NorthCoastModularCollective/BridgeSystemOnRampPrototype/README.md

# BridgeSystemOnRampPrototype
a pure data prototype for the bridge system on ramp
