NorthCoastModularCollective/BridgeSystemOnRampPrototype/hardware/README.MD

This folder contains the designs for PCBs, panels, and other hardware items for the Bridge System Onramp.

Pinout map for v1 hardware
|Pin| MIDI CC | Component|
|----|---|---|
|0| N/A | Decay Input Jack |
|1| N/A | MISO (LCD Screen)|
|2| 17 | Trigger Button|
|3| N/A| SRR (shaper) Input Jack |
|4| N/A | Filter Cutoff Input Jack |
|5| N/A | Envelope Attack Input Jack |
|6| N/A| Waveform Selector Input Jack |
|7| N/A | DIN (SGTL5000 Audio Chip)|
|8| N/A | DOUT (SGTL5000 Audio Chip)|
|9| N/A | Clock Output Jack|
|10| N/A | Trigger Output Jack|
|11| N/A | MOSI (LCD Screen)|
|12| N/A | Sequencer Output Jack|
|13| N/A | Sequencer 4th LED|
|14| 30 | LFO Wave Knob |
|15| 28 | Envelope Attack Input Jack |
|16| 26| SRR (shaper) Input Jack |
|17| 27 | Filter Cutoff Knob |
|18| N/A |SDA (SGTL5000 Audio Chip)|
|19| N/A |SCL (SGTL5000 Audio Chip)|
|20| N/A |LRCLCK (SGTL5000 Audio Chip)|
|21| N/A |BLCK (SGTL5000 Audio Chip)|
|22| 31| LFO Rate Knob |
|23| 32 | LFO Amount Knob |
|24| 44 | Sequencer Fader 1|
|25| 45| Sequencer Fader 2|
|26| 46 | Sequencer Fader 3|
|27| 47 | Sequencer Fader 4|
|28| N/A | LFO Output Jack|
|29| N/A |Sequencer 1st LED|
|30| N/A |Sequencer 2nd LED|
|31| N/A |Sequencer 3rd LED|
|32| N/A | Reset (LCD Screen)|
|33| N/A | MCLK (SGTL5000 Audio Chip)|
|34| 17 | Clock Start/stop Button|
|35| N/A | Rotary Encoder A (clock speed)|
|36| N/A | RS (LCD Screen)|
|37| N/A | CS1 (LCD Screen)|
|38| N/A | Rotary Encoder B (clock speed)|
|39| N/A | Clock LED|
|40| 23 | Envelope Decay Knob|
|41| 25| Oscillator Waveform Knob |
