NorthCoastModularCollective/BridgeSystemOnRampPrototype/hardware/panel/Artboard 1.png

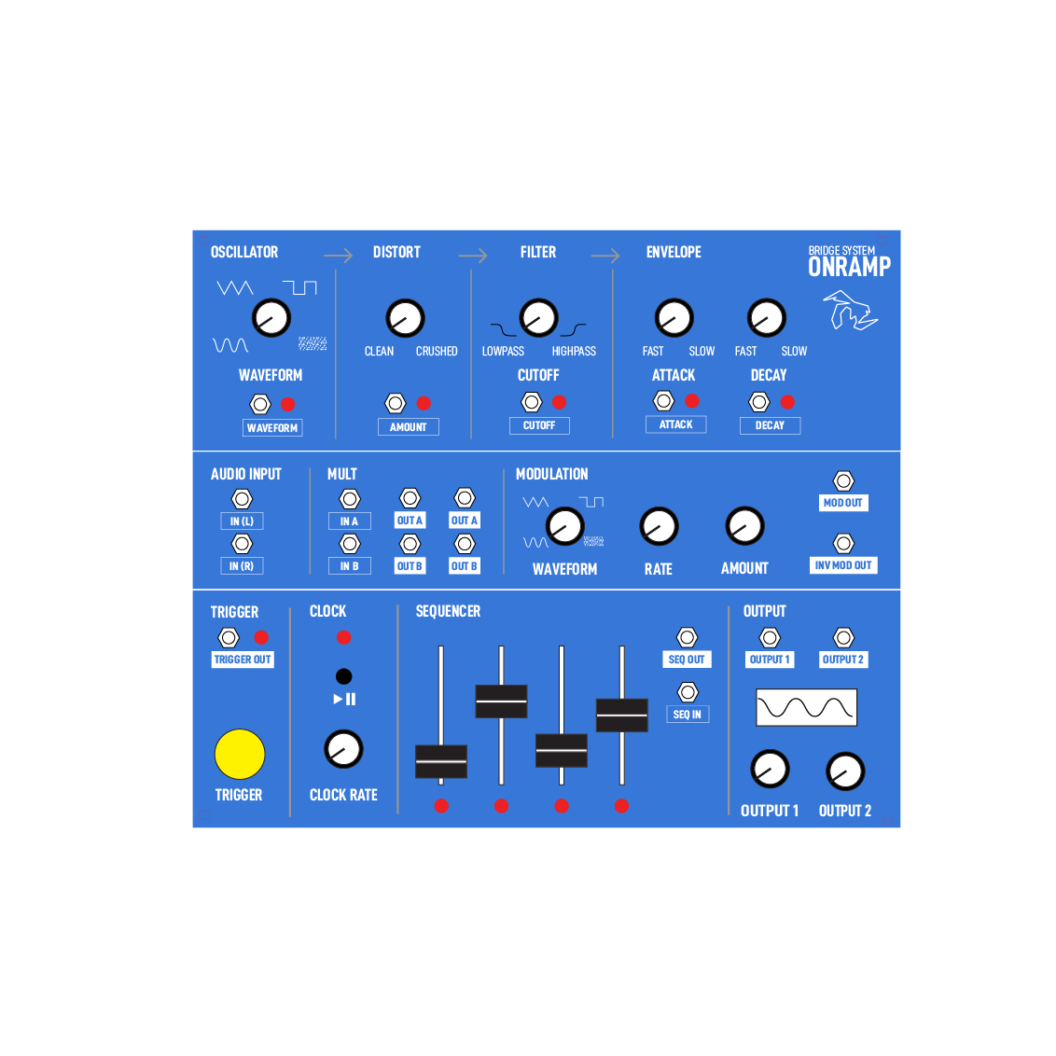
hardware/panel/Artboard 1.png
