NorthCoastModularCollective/BridgeSystemOnRampPrototype/(threads)

Thread 1 (2022-08-02):

TO DO - Onramp PD Prototyp

billvanloo, 2022-08-02:
These are the remaining "TO DO" items from the list @XiNNiW and I made as we were pairing on the PD prototype:

- [ ] Implement resonance control on the filter (PD doesn't give a way to do this for the lop~ or hip~ objects, and trying to implement this on the lpf~ object alone didn't seem quite right. If I remember correctly, David played a bit with using the biquad~ filter object to build our own filters from scratch, but I don't think it's all the way there.
- [ ] Add a layer of abstraction to the PD patch to hide the patch cords between sub-modules. This is a look-and-feel improvement to help the interface feel a little nicer.
- [ ] Add "fade-able" LEDs to reflect the knob or knob+modulation parameters. The idea here is that if a module's parameter can accept modulation, then the LED's brightness value should track the modulation and use PWM to fade the LED. In PD, this probably means building an abstraction to show how this would look.
- [ ] Refactor our patchbay into its own abstraction (@XiNNiW did we already do this?)
- [ ] Add the ability for the sequencer to run at LFO rate (I'm not sure what this note means exactly)
- [ ] Clean up each sub-module's GUI (line up elements, consistent font size & placement, etc)
- [ ] add an "envelope" to the modulation source's wave generation options
- [ ] Add "analog" outpuut from wave generator and two "analog" inputs to output module section (again, not sure what this means exactly)
- [ ] Further work needs to be done on the sequencer; will have to look further at this to give detailed description of what functionality is there and what still needs to be implemented.

Thread 2 (2023-05-27):

OLED schematic needs LED power

joebauer, 2023-05-27:
MH1 and MH2 are the power leads

joebauer, 2023-12-22:
This was added to the OLED breakout board. This board has been built but needs to be tested yet.

Thread 4 (2023-12-03):

Story: Display a line graphic on the LCD

billvanloo, 2023-12-03:
Story:
Display a line graphic on the LCD screen.

Details:
This will set the groundwork for our graphical display on the LCD screen. For now, just make a basic shape (ex: a square) be displayed on the screen.

billvanloo, 2023-12-03:
See also:
[](https://github.com/NorthCoastModularCollective/BridgeSystemOnRampPrototype/issues/3)

Thread 7 (2023-12-03):

Story: use onboard audio output

billvanloo, 2023-12-03:
Story:
Use onboard audio output

Details:
Use the new audio breakout board to get audio out of the prototype system instead of the USB audio output.

billvanloo, 2023-12-03:
Notes: @joebauer has the new audio breakout board hardware, and he will solder it up for testing. Once the hardware is complete, it should be possible to easily change the software/prototyping/audio-test code to use this instead of the USB output.

Thread 9 (2023-12-05):

Discussion: Filter Section

billvanloo, 2023-12-05:
During the last work session with @joebauer and @thynk we discussed a few possible changes to the filter section.

1. We discussed adding back the resonance control, since we're moving to the MUX board which gives us additional inputs.
2. We also discussed the possibility of adding a second filter section, so the instrument would have both lowpass and highpass filters as separate filters. These could be combined to create a bandpass effect. These would have separate cutoff controls, and could either share a common resonance control or have their own resonance controls.
3. We also discussed the possibility of moving from the DJ-style filter control (where it's a lowpass when turned to the left, or a highpass when turned to the right) to using a selector switch of some kind to switch between different filter types (lowpass, bandpass, highpass). In my head, I'm envisioning something like what the Jove filter uses:

https://dt7v1i9vyp3mf.cloudfront.net/styles/news_large/s3/imagelibrary/M/Modular_0917_02-lGJUXO5uQRmUUBVdWYKJVOYRkZ5P_l0y.jpg

billvanloo, 2023-12-05:
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

joebauer, 2023-12-22:
I think I might be leaning more to option #3, but perhaps with the selector being another knob (one I/O used vs. 4?)?
