NorthCoastModularCollective/BridgeSystemOnRampPrototype/hardware/Bridge System On Ramp Prototype001 Panel.pdf

# North Coast Modular Collective

# Attack IN1 TM⁵

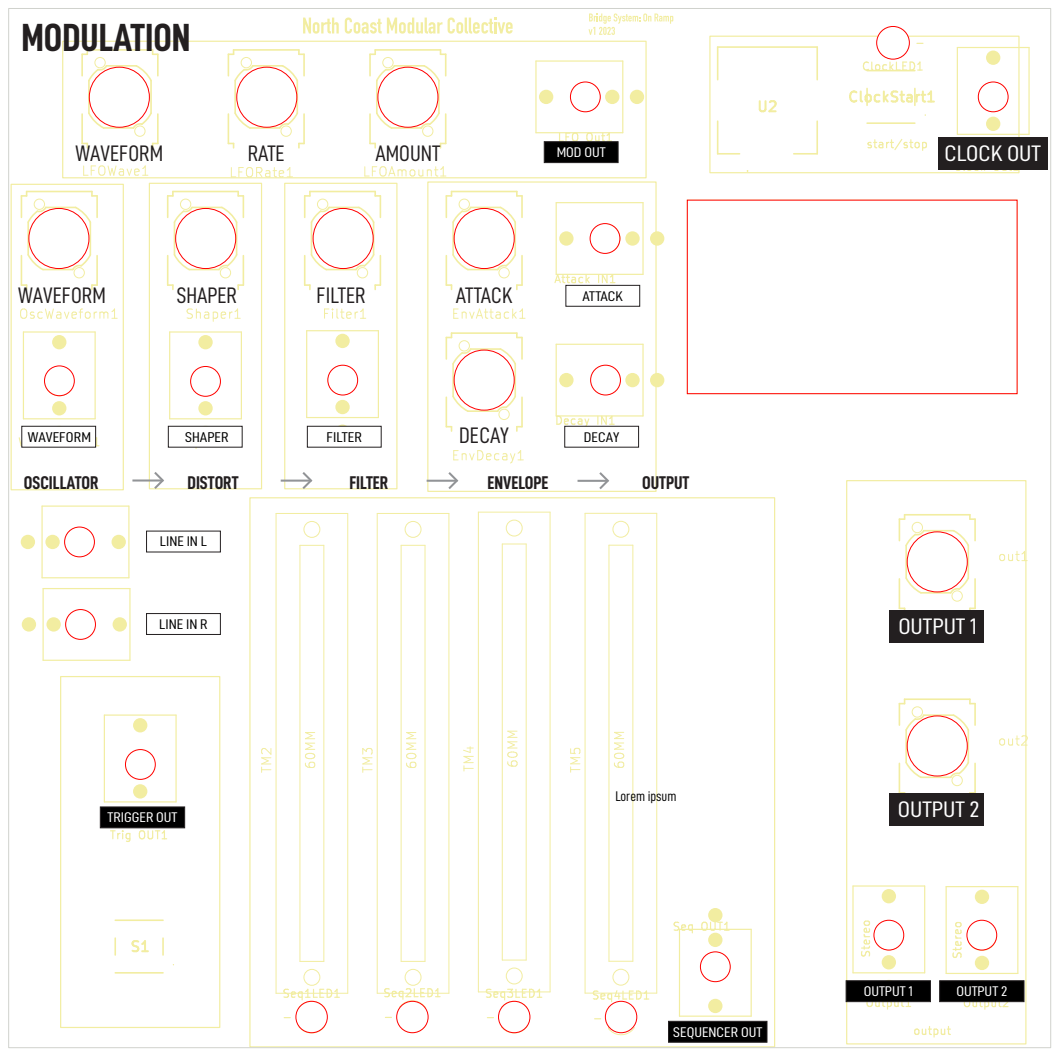
[picture p2: page 1]
Stereo; output; start/stop; LFOAmount1; Shaper1; Seq4LED1; Filter1; Seq2LED1; Output2; out1; Clock; Out1; LCDScreen1; LFO Out1; EnvDecay1; Seq1LED1; Output1 Seq3LED1; Trig OUT1; LineIn_L1; EnvAttack1; out2; LineIn_R1; OscWaveform1; Seq OUT1; Waveform; Shaper; 60MM Filter IN1; Decay IN1; ClockLED1; LFOWave1; ClockStart1; LFORate1; WAVEFORM; SHAPER; FILTER; ATTACK; DECAY; RATE; AMOUNT; MOD OUT; OUTPUT 1; OUTPUT 2; CLOCK OUT; LINE IN L; LINE IN R; TRIGGER OUT; SEQUENCER OUT; Lorem ipsum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

Bridge System: On Ramp
