NorthCoastModularCollective/BridgeSystemOnRampPrototype/hardware/panel/Bridge System Onramp interface ideas v6.pdf

## OSCILLATOR

DISTORT | FILTER | ENVELOPE

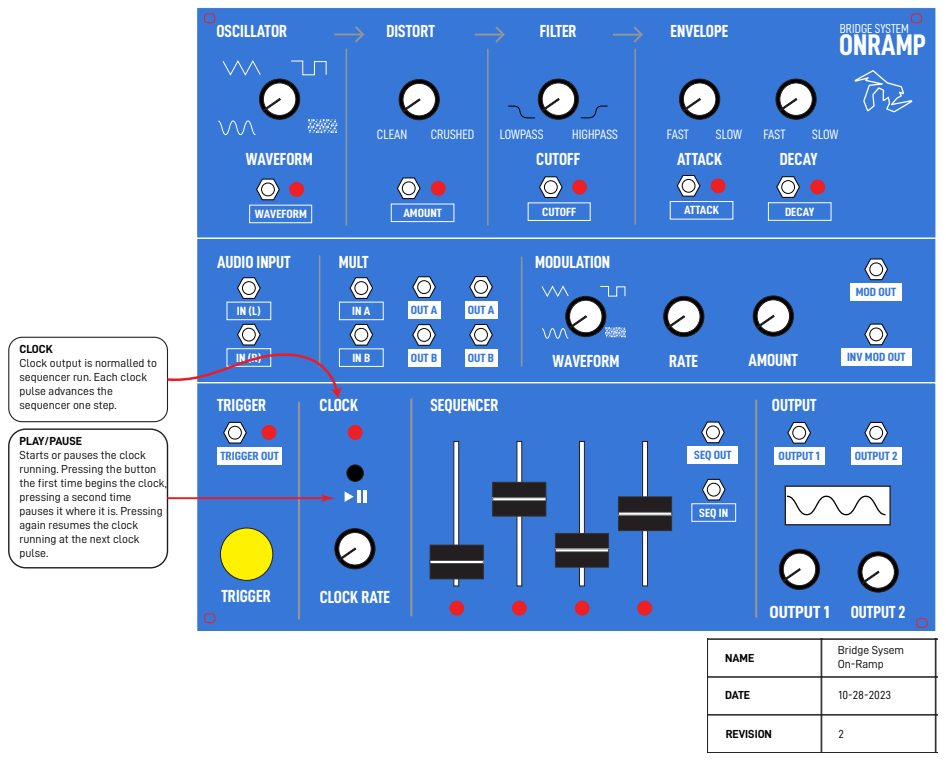
[picture p3: page 1]
AUDIO INPUT; MULT; MODULATION; TRIGGER; CLOCK; SEQUENCER; OUTPUT; WAVEFORM; CUTOFF; OUTPUT 1; CLEAN; CRUSHED; LOWPASS; HIGHPASS; FAST; SLOW; RATE; CLOCK RATE; AMOUNT; ATTACK; OUTPUT 2; DECAY; SEQ OUT; SEQ IN; OUT A; OUT B; TRIGGER OUT; MOD OUT; BRIDGE SYSTEM ONRAMP; REVISION; DATE; NAME; Bridge Sysem On-Ramp

CLOCK
Clock output is normalled to
sequencer run. Each clock
pulse advances the
sequencer one step.

INV MOD OUT

PLAY/PAUSE
Starts or pauses the clock
running. Pressing the button
the first time begins the clock,
pressing a second time
pauses it where it is. Pressing
again resumes the clock
running at the next clock
pulse.
