NorthCoastModularCollective/BridgeSystemOnRampPrototype/hardware/panel/Bridge System Onramp interface ideas v4pdf.pdf

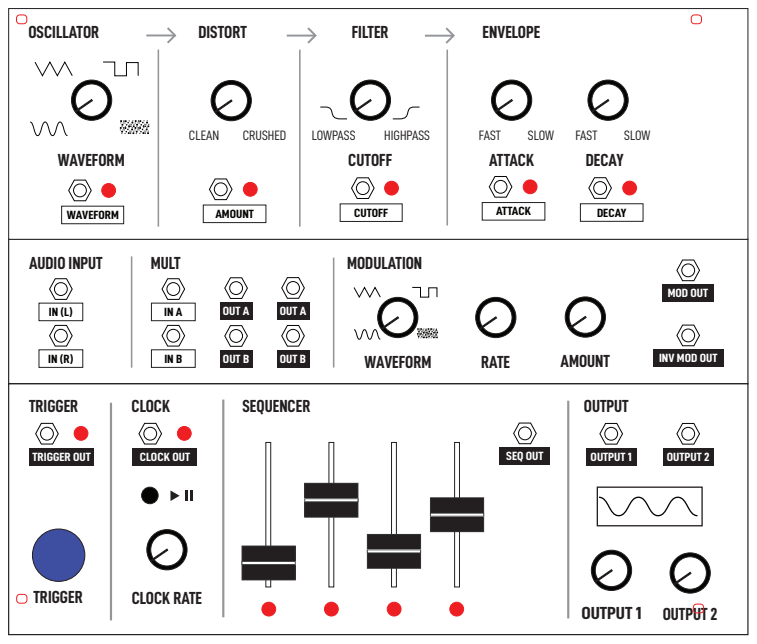
[picture p4: page 1]
AUDIO INPUT; MULT; MODULATION; TRIGGER; CLOCK; SEQUENCER; OUTPUT; OSCILLATOR; WAVEFORM; CUTOFF; DISTORT; FILTER; ENVELOPE; OUTPUT 1; CLEAN; CRUSHED; LOWPASS; HIGHPASS; FAST; SLOW; RATE; CLOCK RATE; AMOUNT; ATTACK; OUTPUT 2; DECAY; SEQ OUT; OUT A; OUT B; TRIGGER OUT; MOD OUT; CLOCK OUT

INV MOD OUT
