NorthCoastModularCollective/BridgeSystemOnRampPrototype/hardware/panel/V2/Bridge System Onramp interface V2-0.pdf

## OSCILLATOR

DISTORT | FILTER | ENVELOPE

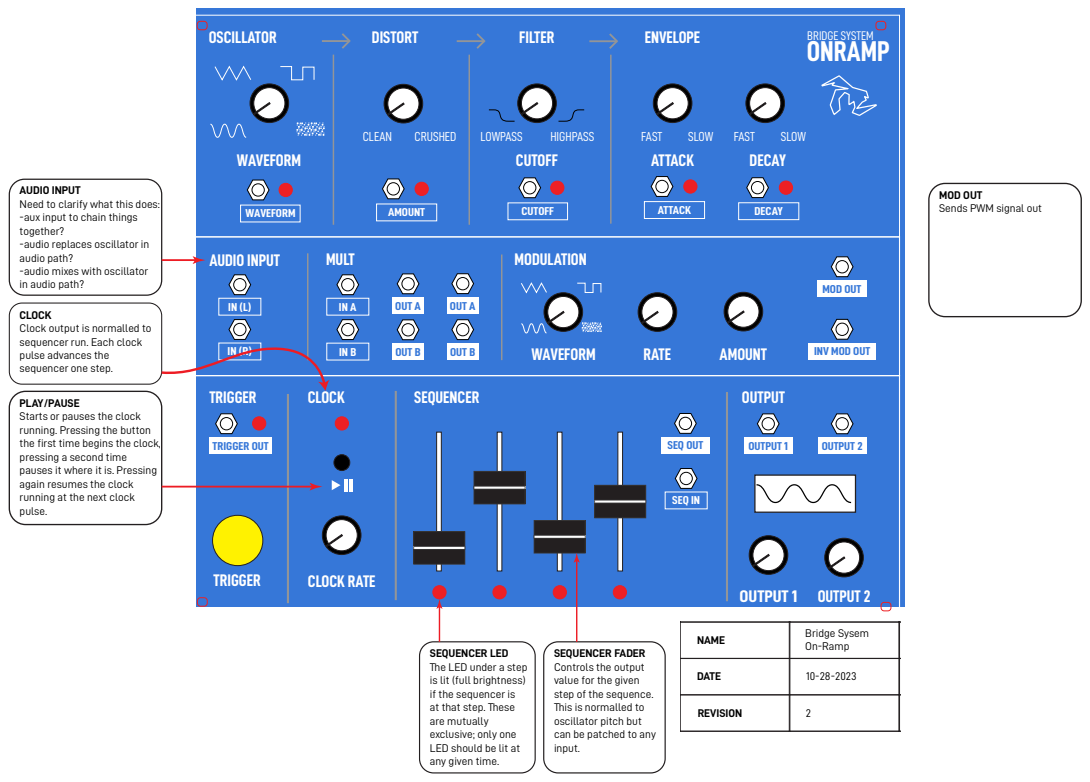
[picture p5: page 1]
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

AUDIO INPUT
Need to clarify what this does:
-aux input to chain things
together?
-audio replaces oscillator in
audio path?
-audio mixes with oscillator
in audio path?

MOD OUT
Sends PWM signal out

CLOCK
Clock output is normalled to
sequencer run. Each clock
pulse advances the
sequencer one step.

INV MOD OUT

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

SEQUENCER LED
The LED under a step
is lit (full brightness)
if the sequencer is
at that step. These
are mutually
exclusive; only one
LED should be lit at
any given time.

SEQUENCER FADER
Controls the output
value for the given
step of the sequence.
This is normalled to
oscillator pitch but
can be patched to any
input.
