NorthCoastModularCollective/BridgeSystemOnRampPrototype/hardware/panel/Bridge System Onramp interface ideas v3.pdf

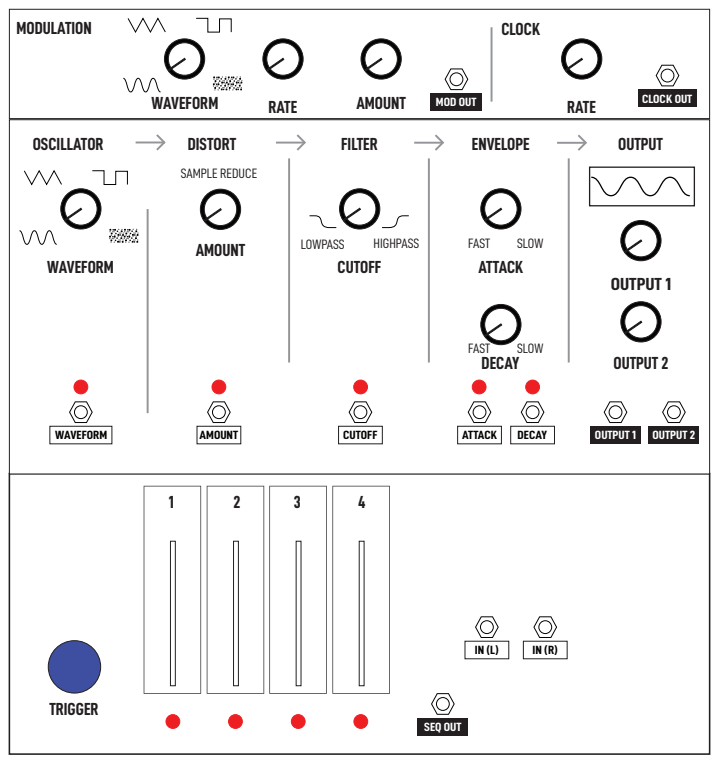
[picture p6: page 1]
MODULATION; OSCILLATOR; WAVEFORM; CUTOFF; DISTORT; FILTER; ENVELOPE; OUTPUT; CLOCK; OUTPUT 1; LOWPASS; HIGHPASS; FAST; SLOW; SAMPLE REDUCE; AMOUNT; TRIGGER; RATE; ATTACK; DECAY; OUTPUT 2; SEQ OUT

CLOCK OUT MOD OUT
