NorthCoastModularCollective/BridgeSystemOnRampPrototype/hardware/panel/Bridge System Onramp interface ideas v2.pdf

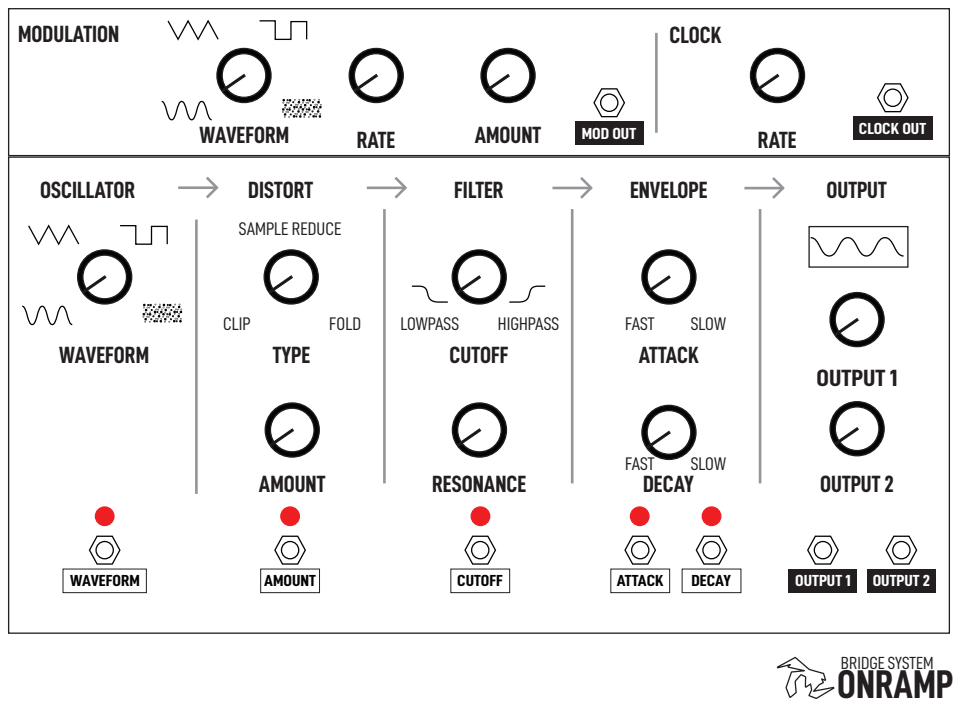
[picture p7: page 1]
MODULATION; ONRAMP; OSCILLATOR; WAVEFORM; TYPE; CUTOFF; DISTORT; FILTER; ENVELOPE; OUTPUT; CLOCK; OUTPUT 1; CLIP; LOWPASS; HIGHPASS; FAST; SLOW; FOLD; SAMPLE REDUCE; AMOUNT; RESONANCE; RATE; ATTACK; DECAY; OUTPUT 2; BRIDGE SYSTEM

CLOCK OUT MOD OUT
