NorthCoastModularCollective/BridgeSystemOnRampPrototype/hardware/Bridge System On Ramp.kicad_pcb

## KiCad design hardware/Bridge System On Ramp.kicad_pcb (2023-12-03)

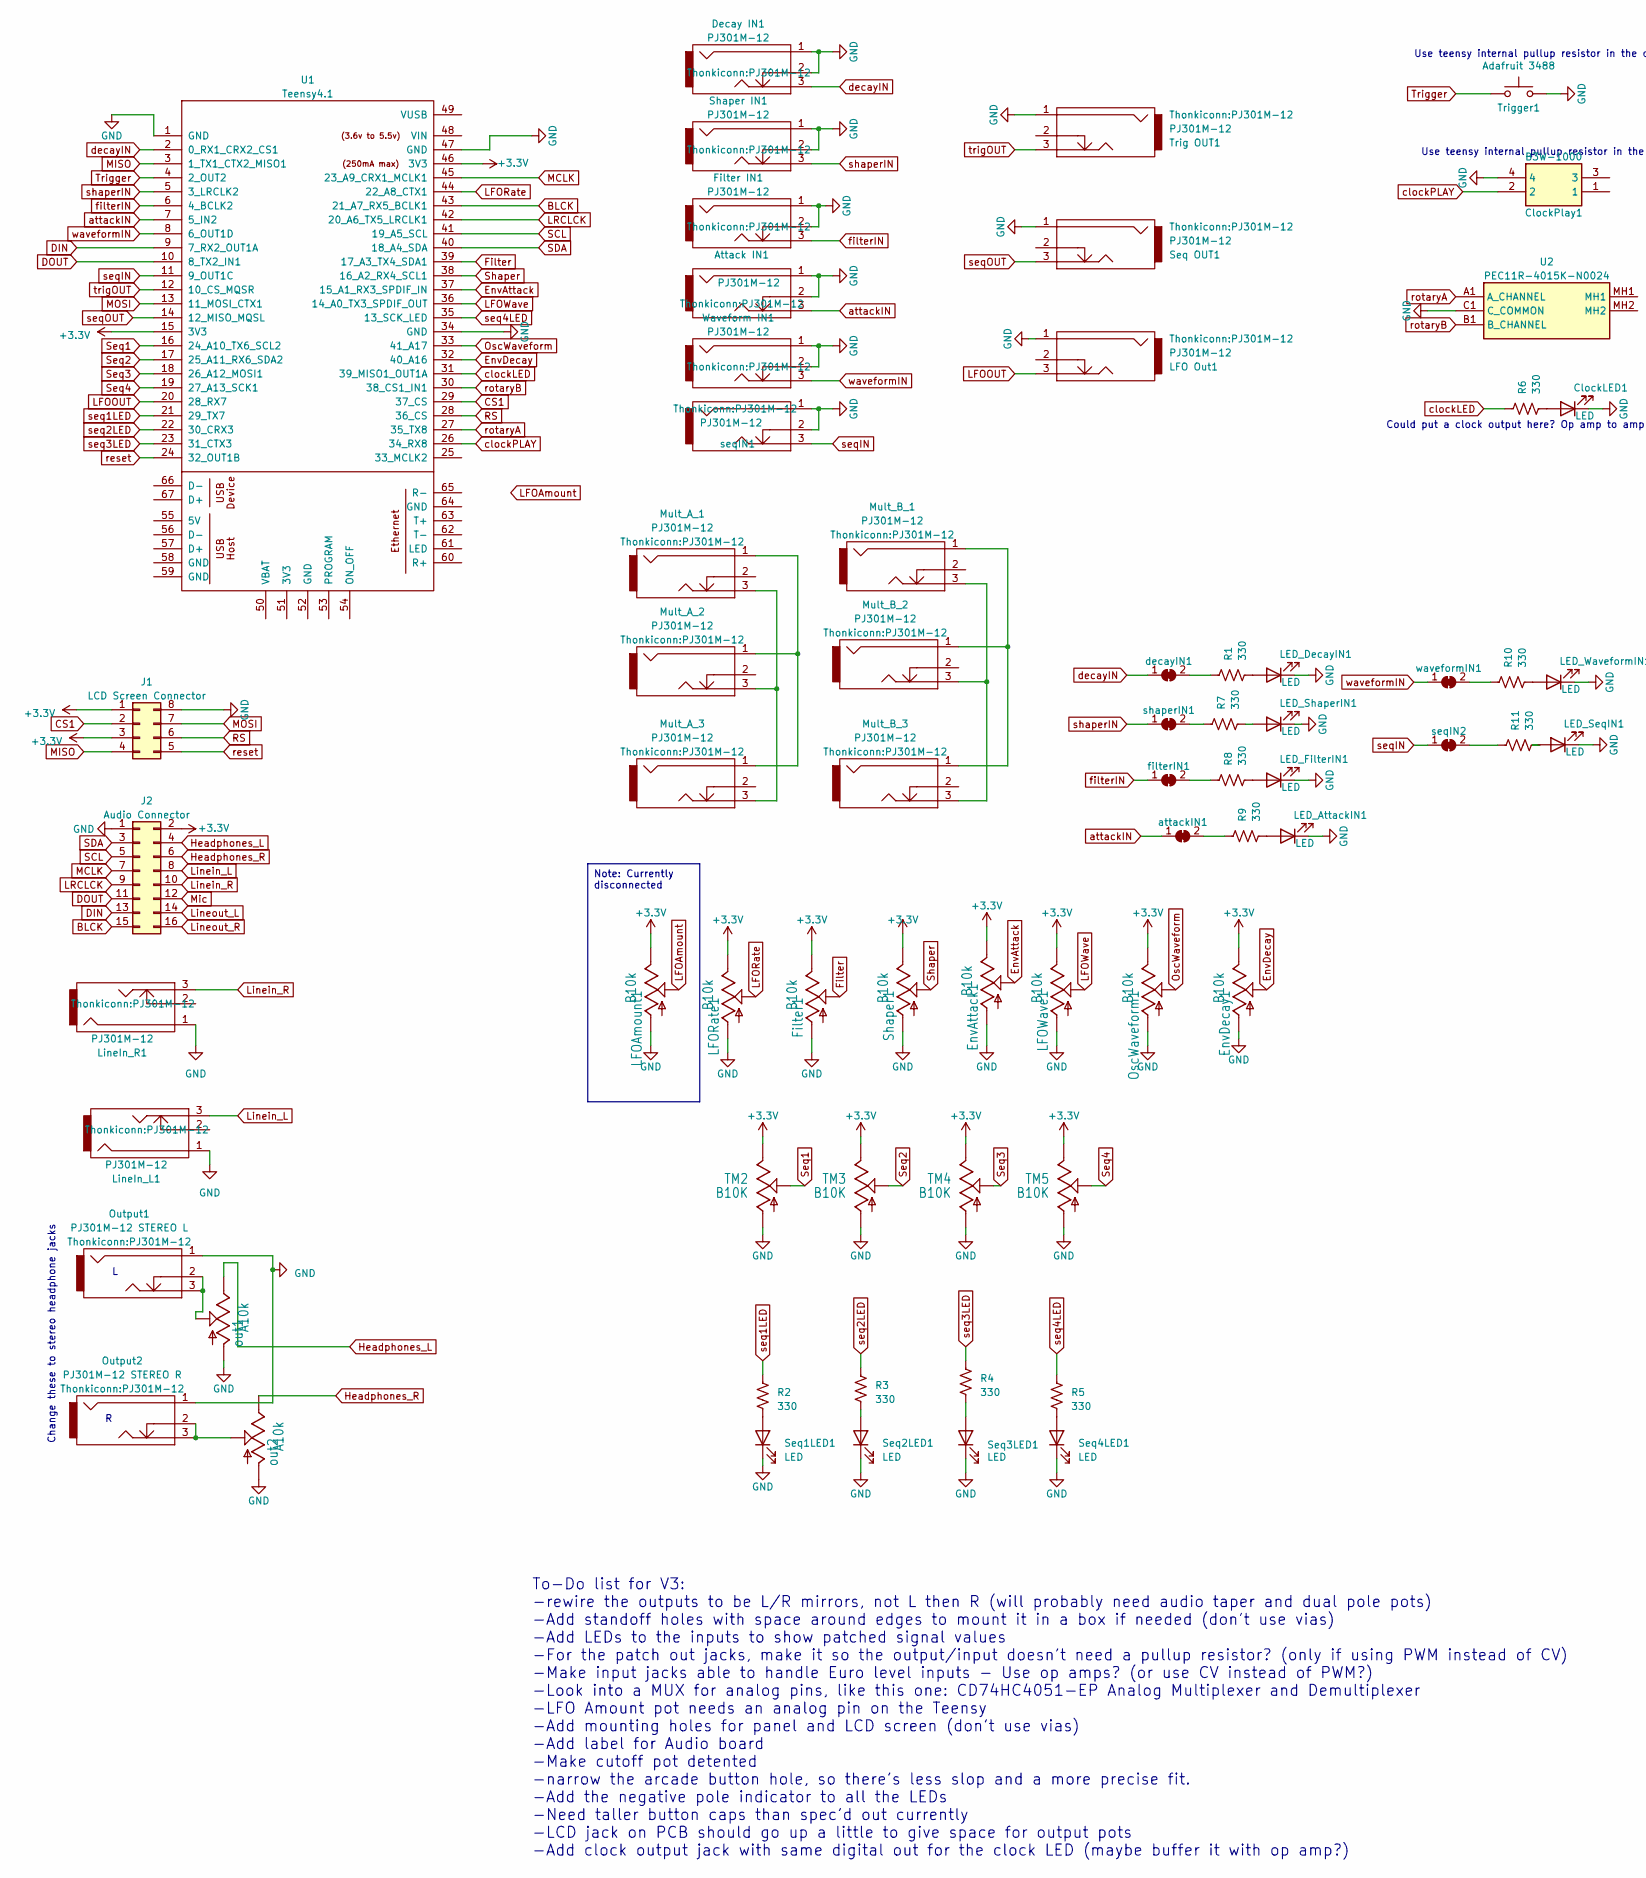
[picture p8: schematic Bridge System On Ramp.kicad_sch, Bridge System: On Ramp, part in row 1, column 1]

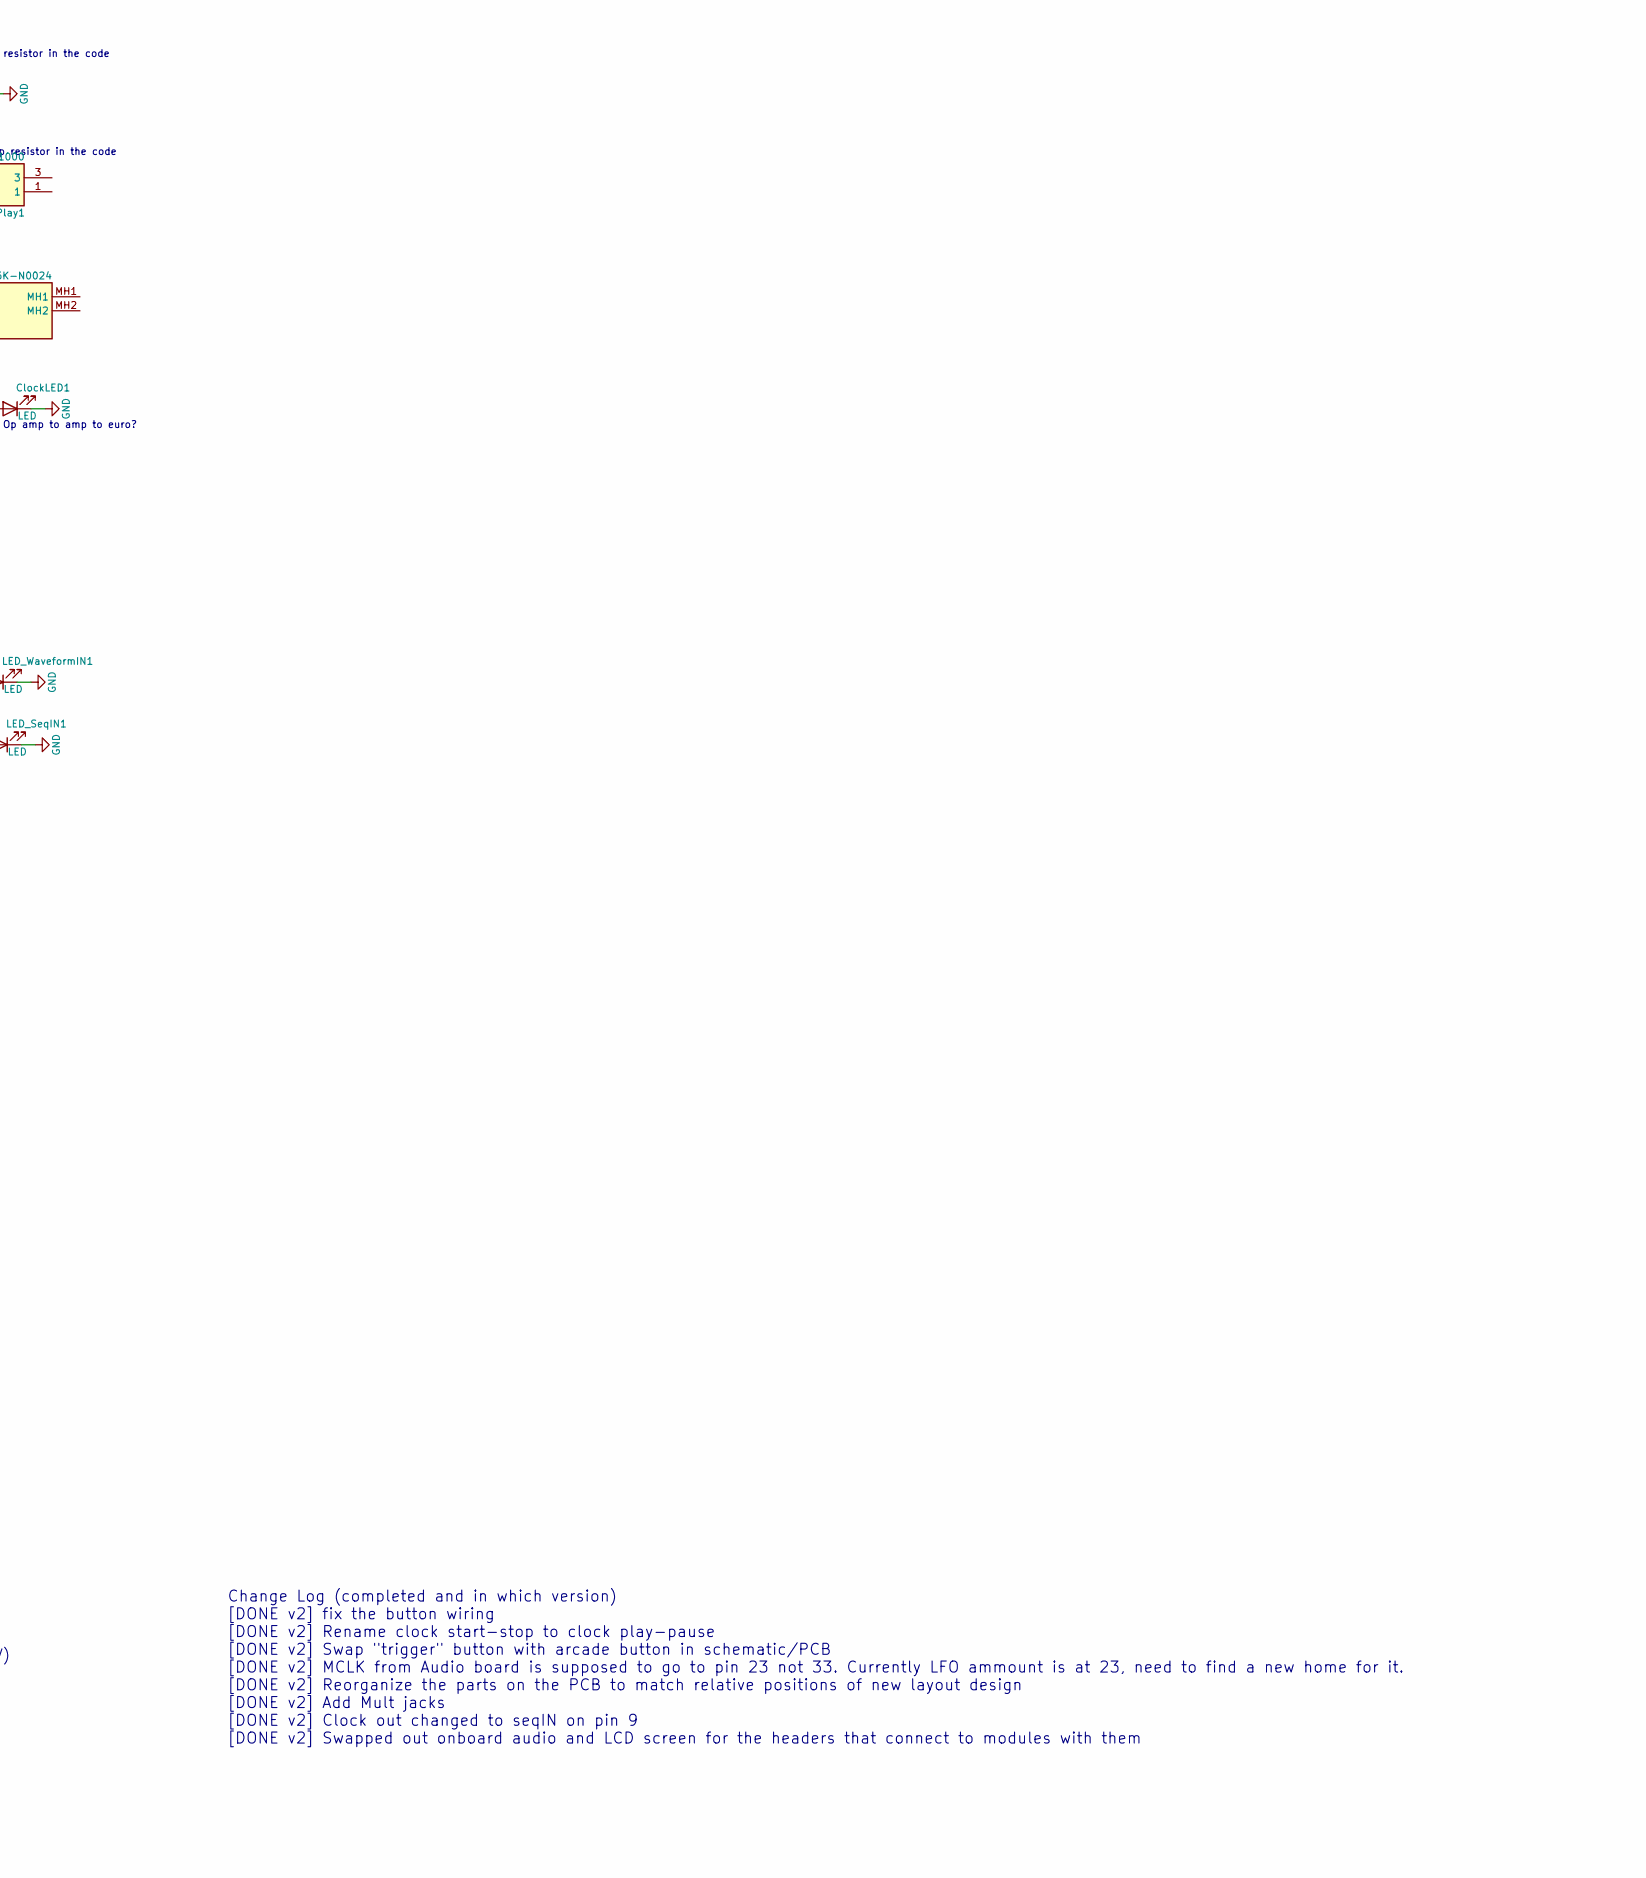
[picture p9: schematic Bridge System On Ramp.kicad_sch, Bridge System: On Ramp, part in row 1, column 2]

Parts:
Attack IN1: PJ301M-12
ClockLED1: LED; LED_D3.0mm
ClockPlay1: B3W-1000; B3W1050; Mouser Part Number 653-B3W-1000
Decay IN1: PJ301M-12
EnvAttack1: B10k; EVUFXL
EnvDecay1: B10k; EVUFXL
Filter1: B10k; EVUFXL
Filter IN1: PJ301M-12
J1: LCD Screen Connector; PinSocket_2x04_P2.00mm_Vertical_SMD
J2: Audio Connector; PinSocket_2x08_P2.00mm_Vertical_SMD; Part Number 1-1602FBV0T
LED_AttackIN1: LED; LED_D3.0mm
LED_DecayIN1: LED; LED_D3.0mm
LED_FilterIN1: LED; LED_D3.0mm
LED_SeqIN1: LED; LED_D3.0mm
LED_ShaperIN1: LED; LED_D3.0mm
LED_WaveformIN1: LED; LED_D3.0mm
LFO Out1: PJ301M-12
LFOAmount1: B10k; EVUFXL
LFORate1: B10k; EVUFXL
LFOWave1: B10k; EVUFXL
LineIn_L1: PJ301M-12
LineIn_R1: PJ301M-12
Mult_A_1, Mult_A_2, Mult_A_3: PJ301M-12
Mult_B_1, Mult_B_2, Mult_B_3: PJ301M-12
OscWaveform1: B10k; EVUFXL
Output1: PJ301M-12 STEREO L; PJ301M-12
Output2: PJ301M-12 STEREO R; PJ301M-12
R1, R2, R3, R4, R5, R6, R7, R8, R9, R10, R11: 330; R_1206_3216Metric_Pad1.30x1.75mm_HandSolder
Seq1LED1, Seq2LED1, Seq3LED1, Seq4LED1: LED; LED_D3.0mm
Seq OUT1: PJ301M-12
Shaper1: B10k; EVUFXL
Shaper IN1: PJ301M-12
TM2, TM3, TM4, TM5: B10K; SLIDEPOT-60
Trig OUT1: PJ301M-12
Trigger1: Adafruit 3488; PinSocket_1x02_P2.54mm_Horizontal; Mouser Part Number 653-B3W-1000
U1: Teensy4.1; Teensy41
U2: PEC11R-4015K-N0024; PEC11R4015KN0024; Mouser Part Number 652-PEC11R-4015K-N24
Waveform IN1: PJ301M-12
attackIN1: (no value)
decayIN1: (no value)
filterIN1: (no value)
out1, out2: A10k; EVUFXL
seqIN1: PJ301M-12
seqIN2: (no value)
shaperIN1: (no value)
waveformIN1: (no value)

Connections:
+3.3V: EnvAttack1.3 (E), EnvDecay1.3 (E), Filter1.3 (E), J1.1, J1.3, J2.2, LFOAmount1.3 (E), LFORate1.3 (E), LFOWave1.3 (E), OscWaveform1.3 (E), Shaper1.3 (E), TM2.B, TM3.B, TM4.B, TM5.B, U1.15 (3V3), U1.46 (3V3)
BLCK: J2.15 (-12V), U1.43 (21_A7_RX5_BCLK1)
CS1: J1.2, U1.29 (37_CS)
DIN: J2.13 (-12), U1.9 (7_RX2_OUT1A)
DOUT: J2.11 (GND), U1.10 (8_TX2_IN1)
EnvAttack: EnvAttack1.2 (S), U1.37 (15_A1_RX3_SPDIF_IN)
EnvDecay: EnvDecay1.2 (S), U1.32 (40_A16)
Filter: Filter1.2 (S), U1.39 (17_A3_TX4_SDA1)
GND: Attack IN1.1, Attack IN1.2, ClockLED1.1 (K), ClockPlay1.4, Decay IN1.1, Decay IN1.2, EnvAttack1.1 (A), EnvDecay1.1 (A), Filter1.1 (A), Filter IN1.1, Filter IN1.2, J1.8, J2.1, LED_AttackIN1.1 (K), LED_DecayIN1.1 (K), LED_FilterIN1.1 (K), LED_SeqIN1.1 (K), LED_ShaperIN1.1 (K), LED_WaveformIN1.1 (K), LFO Out1.1, LFOAmount1.1 (A), LFORate1.1 (A), LFOWave1.1 (A), LineIn_L1.1, LineIn_R1.1, OscWaveform1.1 (A), Output1.1, Output2.1, Seq1LED1.1 (K), Seq2LED1.1 (K), Seq3LED1.1 (K), Seq4LED1.1 (K), Seq OUT1.1, Shaper1.1 (A), Shaper IN1.1, Shaper IN1.2, TM2.A, TM3.A, TM4.A, TM5.A, Trig OUT1.1, Trigger1.2, U1.1 (GND), U1.34 (GND), U1.47 (GND), U2.C1 (C_COMMON), Waveform IN1.1, Waveform IN1.2, out1.1 (A), out2.1 (A), seqIN1.1, seqIN1.2
Headphones_L: J2.4, out1.3 (E)
Headphones_R: J2.6, out2.3 (E)
LFOAmount: LFOAmount1.2 (S)
LFOOUT: LFO Out1.3, U1.20 (28_RX7)
LFORate: LFORate1.2 (S), U1.44 (22_A8_CTX1)
LFOWave: LFOWave1.2 (S), U1.36 (14_A0_TX3_SPDIF_OUT)
LRCLCK: J2.9 (GND), U1.42 (20_A6_TX5_LRCLK1)
Linein_L: J2.8 (+12V), LineIn_L1.3
Linein_R: J2.10 (GND), LineIn_R1.3
Lineout_L: J2.14 (-12V)
Lineout_R: J2.16
MCLK: J2.7 (12V), U1.45 (23_A9_CRX1_MCLK1)
MISO: J1.4, U1.3 (1_TX1_CTX2_MISO1)
MOSI: J1.7, U1.13 (11_MOSI_CTX1)
Mic: J2.12 (GND)
unnamed: ClockLED1.2 (A), R6.1
unnamed: LED_AttackIN1.2 (A), R9.1
unnamed: LED_DecayIN1.2 (A), R1.1
unnamed: LED_FilterIN1.2 (A), R8.1
unnamed: LED_SeqIN1.2 (A), R11.1
unnamed: LED_ShaperIN1.2 (A), R7.1
unnamed: LED_WaveformIN1.2 (A), R10.1
unnamed: Mult_A_1.1, Mult_A_2.1, Mult_A_3.1
unnamed: Mult_A_1.3, Mult_A_2.3, Mult_A_3.3
unnamed: Mult_B_1.1, Mult_B_2.1, Mult_B_3.1
unnamed: Mult_B_1.3, Mult_B_2.3, Mult_B_3.3
unnamed: R2.1, Seq1LED1.2 (A)
unnamed: R3.1, Seq2LED1.2 (A)
unnamed: R4.1, Seq3LED1.2 (A)
unnamed: R5.1, Seq4LED1.2 (A)
unnamed: R9.2, attackIN1.2 (B)
unnamed: R1.2, decayIN1.2 (B)
unnamed: R8.2, filterIN1.2 (B)
unnamed: Output1.2, Output1.3, out1.2 (S)
unnamed: Output2.2, Output2.3, out2.2 (S)
unnamed: R11.2, seqIN2.2 (B)
unnamed: R7.2, shaperIN1.2 (B)
unnamed: R10.2, waveformIN1.2 (B)
OscWaveform: OscWaveform1.2 (S), U1.33 (41_A17)
RS: J1.6, U1.28 (36_CS)
SCL: J2.5 (+12V), U1.41 (19_A5_SCL)
SDA: J2.3, U1.40 (18_A4_SDA)
Seq1: TM2.WIPER, U1.16 (24_A10_TX6_SCL2)
Seq2: TM3.WIPER, U1.17 (25_A11_RX6_SDA2)
Seq3: TM4.WIPER, U1.18 (26_A12_MOSI1)
Seq4: TM5.WIPER, U1.19 (27_A13_SCK1)
Shaper: Shaper1.2 (S), U1.38 (16_A2_RX4_SCL1)
Trigger: Trigger1.1, U1.4 (2_OUT2)
attackIN: Attack IN1.3, U1.7 (5_IN2), attackIN1.1 (A)
clockLED: R6.2, U1.31 (39_MISO1_OUT1A)
clockPLAY: ClockPlay1.2, U1.26 (34_RX8)
decayIN: Decay IN1.3, U1.2 (0_RX1_CRX2_CS1), decayIN1.1 (A)
filterIN: Filter IN1.3, U1.6 (4_BCLK2), filterIN1.1 (A)
reset: J1.5, U1.24 (32_OUT1B)
rotaryA: U1.27 (35_TX8), U2.A1 (A_CHANNEL)
rotaryB: U1.30 (38_CS1_IN1), U2.B1 (B_CHANNEL)
seq1LED: R2.2, U1.21 (29_TX7)
seq2LED: R3.2, U1.22 (30_CRX3)
seq3LED: R4.2, U1.23 (31_CTX3)
seq4LED: R5.2, U1.35 (13_SCK_LED)
seqIN: U1.11 (9_OUT1C), seqIN1.3, seqIN2.1 (A)
seqOUT: Seq OUT1.3, U1.14 (12_MISO_MQSL)
shaperIN: Shaper IN1.3, U1.5 (3_LRCLK2), shaperIN1.1 (A)
trigOUT: Trig OUT1.3, U1.12 (10_CS_MQSR)
waveformIN: U1.8 (6_OUT1D), Waveform IN1.3, waveformIN1.1 (A)

Notes on the sheet:
Note: Currently disconnected
Use teensy internal pullup resistor in the code
Change these to stereo headphone jacks
Could put a clock output here? Op amp to amp to euro?
Change Log (completed and in which version) [DONE v2] fix the button wiring [DONE v2] Rename clock start-stop to clock play-pause [DONE v2] Swap "trigger" button with arcade button in schematic/PCB [DONE v2] MCLK from Audio board is supposed to go to pin 23 not 33. Currently LFO ammount is at 23, n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
To-Do list for V3: -rewire the outputs to be L/R mirrors, not L then R (will probably need audio taper and dual pole pots) -Add standoff holes with space around edges to mount it in a box if needed (don't use vias) -Add LEDs to the inputs to show patched signal values -For the patch out jacks, make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

Board: 2 copper layers, 61 parts (13 on the bottom side), 64 nets, no tracks yet.
