NorthCoastModularCollective/BridgeSystemOnRampPrototype/bridge-system-firmware/bridge-system-firmware.ino

/*
  North Coast Modular Collective Bridge System: On Ramp
  ---------------------------------------------------------
  Copyright 2023 North Coast Modular Collective
  MIT License:
  Permission is hereby granted, free of charge, to any person obtaining a copy
  of this software and associated documentation files (the "Software"), to deal
  in the Software without restriction, including without limitation the rights
  to use, copy, modify, merge, publish, distribute, sublicense, and/or sell
  copies of the Software, and to permit persons to whom the Software is
  furnished to do so, subject to the following conditions:

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
  THE SOFTWARE IS PROVIDED "AS IS", WITHOUT WARRANTY OF ANY KIND, EXPRESS OR
  IMPLIED, INCLUDING BUT NOT LIMITED TO THE WARRANTIES OF MERCHANTABILITY,
  FITNESS FOR A PARTICULAR PURPOSE AND NONINFRINGEMENT. IN NO EVENT SHALL THE
  AUTHORS OR COPYRIGHT HOLDERS BE LIABLE FOR ANY CLAIM, DAMAGES OR OTHER
  LIABILITY, WHETHER IN AN ACTION OF CONTRACT, TORT OR OTHERWISE, ARISING FROM,
  OUT OF OR IN CONNECTION WITH THE SOFTWARE OR THE USE OR OTHER DEALINGS IN THE
  SOFTWARE.
  ----------------------------------------------------------

  Note: Make sure "MIDI" is selected from the "Tools > USB Type" menu in the
  Arduino IDE so that it shows up as a MIDI interface.
*/
//#include <Bounce2.h>

#define DECAY_IN_PIN 0                 // Decay In
#define MISO_LCD_PIN 1                 // MISO (LCD Screen)
#define TRIGGER_BUTTON_PIN 2           // Trigger button
#define SHAPER_IN_PIN 3                // shaper in
#define FILTER_IN_PIN 4                // filter in
#define ATTACK_IN_PIN 5                // attack in
#define WAVEFORM_IN_PIN 6              // waveform in
#define DIN_AUDIO_PIN 7                // DIN (SGTL5000 Audio Chip)
#define DOUT_AUDIO_PIN 8               // DOUT (SGTL5000 Audio Chip)
#define CLOCK_OUT_PIN 9                // clock Out
#define TRIGGER_OUT_PIN 10             // trigger Out
#define MOSI_LCD_PIN 11                // MOSI (LCD Screen)
#define SEQUENCER_OUT_PIN 12           // Sequencer Out
#define LFO_WAVE_KNOB_PIN 14           // LFO Wave
#define ENV_ATTACK_KNOB_PIN 15         // Envelope Attack
#define SHAPER_KNOB_PIN 16             // Shaper
#define FILTER_KNOB_PIN 17             // Filter
#define SDA_AUDIO_PIN 18               // SDA (SGTL5000 Audio Chip)
#define SCL_AUDIO_PIN 19               // SCL (SGTL5000 Audio Chip)
#define LRCLCK_AUDIO_PIN 20            // LRCLCK (SGTL5000 Audio Chip)
#define BLCK_AUDIO_PIN 21              // BLCK (SGTL5000 Audio Chip)
#define LFO_RATE_KNOB_PIN 22           // LFO Rate
#define LFO_AMOUNT_KNOB_PIN 23         // LFO Amount
#define SEQ_FADER1_PIN 24              // Sequencer fader 1
#define SEQ_FADER2_PIN 25              // Sequencer fader 2
#define SEQ_FADER3_PIN 26              // Sequencer fader 3
#define SEQ_FADER4_PIN 27              // Sequencer fader 4
#define LFO_OUT_PIN 28                 // LFO Output
#define SEQUENCER_LED1_PIN 29          // Sequencer 1st LED
#define SEQUENCER_LED2_PIN 30          // Sequencer 2nd LED
#define SEQUENCER_LED3_PIN 31          // Sequencer 3rd LED
#define SEQUENCER_LED4_PIN 13          // Sequencer 4th LED
#define RESET_LCD_PIN 32               // reset (LCD Screen)
#define MCLK_AUDIO_PIN 33              // MCLK (SGTL5000 Audio Chip)
#define CLOCK_START_STOP_BUTTON_PIN 34 // Clock Start/stop Button
#define CLOCK_SPEED_ENCODER_PINA 35    // Rotary Encoder A (clock speed)
#define RS_LCD_PIN 36                  // RS (LCD Screen)
#define CS1_LCD_PIN 37                 // CS1 (LCD Screen)
#define CLOCK_SPEED_ENCODER_PINB 38    // Rotary Encoder B (clock speed)
#define CLOCK_LED_PIN 39               // Clock LED
#define ENVELOPE_DECAY_KNOB_PIN 40     // Envelope Decay
#define OSCILLATOR_WAVE_KNOB_PIN 41    // Oscillator Wave Form
#define NUM_LEDS 5
#define NUM_SEQ_STEPS 4
#define NUM_KNOB_PINS 8
#define NUM_BUTTONS 2
#define NUM_PATCH_INPUT_PINS 5
#define NUM_PATCH_OUTPUT_PINS 4
#define MIN_PIN_READING 0
#define MAX_PIN_READING 1023

short ledPins[NUM_LEDS] = {SEQUENCER_LED1_PIN, SEQUENCER_LED2_PIN, SEQUENCER_LED3_PIN, SEQUENCER_LED4_PIN, CLOCK_LED_PIN };

short seqFaderPins[NUM_SEQ_STEPS] = {SEQ_FADER1_PIN, SEQ_FADER2_PIN,
                                     SEQ_FADER3_PIN, SEQ_FADER4_PIN};
short knobPins[NUM_KNOB_PINS] = {
    SHAPER_KNOB_PIN,         FILTER_KNOB_PIN,         LFO_RATE_KNOB_PIN,
    LFO_AMOUNT_KNOB_PIN,     LFO_WAVE_KNOB_PIN,       ENV_ATTACK_KNOB_PIN,
    ENVELOPE_DECAY_KNOB_PIN, OSCILLATOR_WAVE_KNOB_PIN};

short patchInputPins[NUM_PATCH_INPUT_PINS] = {WAVEFORM_IN_PIN, SHAPER_IN_PIN, FILTER_IN_PIN, ATTACK_IN_PIN, DECAY_IN_PIN };
short patchOutputPins[NUM_PATCH_OUTPUT_PINS] = {CLOCK_OUT_PIN, TRIGGER_OUT_PIN, SEQUENCER_OUT_PIN, LFO_OUT_PIN};

//Bounce clockStartStopButton = Bounce();
//Bounce triggerButton = Bounce();
//Bounce buttons[NUM_BUTTONS] = {triggerButton, clockStartStopButton};
short buttonPins[NUM_BUTTONS] = {TRIGGER_BUTTON_PIN, CLOCK_START_STOP_BUTTON_PIN};
//Bounce clockStartStopButton = Bounce();
//Bounce triggerButton = Bounce();
//Bounce buttons[NUM_BUTTONS] = {clockStartStopButton, triggerButton};

// the MIDI channel number to send messages
const int midiChannel = 1;

int faderValues[NUM_SEQ_STEPS] = {0, 0, 0, 0};
int faderCCNumbers[NUM_SEQ_STEPS] = {44, 45, 46, 47};
int knobValues[NUM_KNOB_PINS] = {0, 0, 0, 0, 0, 0, 0, 0};
int knobCCNumbers[NUM_KNOB_PINS] = {26, 27, 31, 32, 30, 28, 23, 25};
int buttonValues[NUM_BUTTONS] = {0,0};
int patchInputValues[NUM_PATCH_INPUT_PINS] = {0,0,0,0,0};
int buttonCCNumbers[NUM_BUTTONS] = {17,18};


// AUDIO GRAPH

#include <Audio.h>
#include <Wire.h>
#include <SPI.h>
#include <SD.h>
#include <SerialFlash.h>

// GUItool: begin automatically generated code
AudioInputI2S            i2s2Input;           //xy=316.33331298828125,249.33331298828125
AudioSynthWaveformSine   sine1;          //xy=331.33331298828125,436.33331298828125
AudioMixer4              mixerR; //xy=497.33331298828125,337.3333435058594
AudioMixer4              mixerL;         //xy=513.3333129882812,248.33331298828125
AudioOutputI2S           i2s1Output;           //xy=640.3333282470703,279.3333282470703
AudioOutputUSB           audioOutput;           //xy=658.3333282470703,346.3333282470703
AudioConnection          patchCord1(i2s2Input, 0, mixerL, 0);
AudioConnection          patchCord2(i2s2Input, 1, mixerR, 0);
AudioConnection          patchCord3(sine1, 0, mixerL, 2);
AudioConnection          patchCord4(sine1, 0, mixerR, 2);
AudioConnection          patchCord5(mixerR, 0, i2s1Output, 1);
AudioConnection          patchCord6(mixerR, 0, audioOutput, 1);
AudioConnection          patchCord7(mixerL, 0, i2s1Output, 0);
AudioConnection          patchCord8(mixerL, 0, audioOutput, 0);
// GUItool: end automatically generated code

AudioControlSGTL5000     sgtl5000_1;     //xy=302,184


// GUItool: end automatically generated code
const int AUDIO_INPUT = AUDIO_INPUT_LINEIN;
void setup() {
  for(int i = 0; i < NUM_BUTTONS; i++){
    pinMode(buttonPins[i], INPUT_PULLUP);
  }
  for(int i = 0; i < NUM_PATCH_INPUT_PINS; i++){
    pinMode(patchInputPins[i], INPUT_PULLUP);
  }
  for(int i = 0; i < NUM_PATCH_OUTPUT_PINS; i++){
    pinMode(patchOutputPins[i], OUTPUT);
  }
  for(int i = 0; i < NUM_LEDS; i++){
    pinMode(ledPins[i], OUTPUT);
  }

  //clockStartStopButton.attach(CLOCK_START_STOP_BUTTON_PIN);
  //triggerButton.attach(TRIGGER_BUTTON_PIN);
  //digitalWrite(SEQ_FADER4_PIN, HIGH);
  AudioMemory(20);
  AudioNoInterrupts();
  sgtl5000_1.enable();
  sgtl5000_1.inputSelect(AUDIO_INPUT);
  sgtl5000_1.volume(0.5);
  sine1.amplitude(9.0);
  sine1.frequency(440.0);
  AudioInterrupts();
}

void loop() {
  readButtons();
  readFaders();
  readKnobs();
  writePatchOutputs();
  readPatchInputs();
  updateMidi();
  updateParameters();
  if(buttonValues[1]==LOW){ digitalWrite(SEQUENCER_LED1_PIN, HIGH);} else {digitalWrite(SEQUENCER_LED1_PIN, LOW);}
  if(patchInputValues[1]==LOW){ digitalWrite(SEQUENCER_LED2_PIN, HIGH);} else {digitalWrite(SEQUENCER_LED2_PIN, LOW);}
  delay(20);
}

void readButtons(){
    for(int i = 0; i < NUM_BUTTONS; i++){
      buttonValues[i] = digitalRead(buttonPins[i]);
    }
}

void readFaders() {
  for (int i = 0; i < NUM_SEQ_STEPS; i++) {
    faderValues[i] = analogRead(seqFaderPins[i]);
  }
}

void readKnobs() {
  for (int i = 0; i < NUM_KNOB_PINS; i++) {
    knobValues[i] = analogRead(knobPins[i]);
  }
}

void readPatchInputs() {
  for (int i = 0; i < NUM_PATCH_INPUT_PINS; i++) {
    patchInputValues[i] = digitalRead(patchInputPins[i]);
  }
}

void writePatchOutputs() {
  for (int i = 0; i < NUM_PATCH_OUTPUT_PINS; i++) {
     digitalWrite(patchOutputPins[i],LOW);
  }
}

void updateMidi() {

  for (int i = 0; i < NUM_SEQ_STEPS; i++) {
    usbMIDI.sendControlChange(
        faderCCNumbers[i], mapFaderValueToNoteRange(faderValues[i]), midiChannel);
  }
  for (int i = 0; i < NUM_KNOB_PINS; i++) {
    usbMIDI.sendControlChange(knobCCNumbers[i],
                              map(knobValues[i], MIN_PIN_READING, MAX_PIN_READING, 0, 127), midiChannel);
  }
  for (int i = 0; i < NUM_BUTTONS; i++){
    usbMIDI.sendControlChange(buttonCCNumbers[i], buttonValues[i], midiChannel);
  }
}

void updateParameters(){

}

float mapFaderValueToNoteRange(int faderValue){
    const float MAX_NOTE = 96;
    const float MIN_NOTE = 21;
    return (float(faderValue)/float(MAX_PIN_READING))*(MAX_NOTE-MIN_NOTE)+MIN_NOTE;
}
