NorthCoastModularCollective/BridgeSystemOnRampPrototype/(commit log)

2022-07-23 adding current state of prototype
2022-07-23 Bugfix summary
    Bug fixes:
    1. Refactored downsampling-filter logic from Saw-Square core into abstraction and added to SRR output to prevent clicking.
    2. Clipped modulation for Attack and Decay parameters to usable range
    3. Changed minimum Decay value to 5ms
    4. Fixed Speed control knob on Wave submodule
2022-07-23 fixed default value for filter object
2022-07-24 experimented with adding some rough symbols and signal flow
2023-05-18 version 1
    Warning: These files are under active development and have not yet been tested.
    [Bridge System On Ramp.kicad_pcb, Bridge System On Ramp.kicad_sch]
2023-05-24 v1 BOM added
2023-06-09 Update README.txt
    added Teensy pin mappings
2023-06-09 first pass at hello world sketch
    All four LEDs on
2023-06-09 added a sketch with pin assignments and usb midi prototype
2023-06-09 whoops... used led pins instead of fader pins... fader 4 mysteriously worked?
2023-06-16 First panel design for prototype
    First panel design for prototype, created in Fusion 360
2023-06-16 added buttons to pd patch
2023-06-16 firmware sends button presses?
2023-06-16 adding pullup mode for buttons
2023-06-16 adding spike to turn on led on button press
2023-06-17 do we have buttons now?
2023-06-17 led test 2
2023-11-12 Minor schematic updates - mostly notes to self
2023-11-12 Starting to work on Rev 2 of the HW
    [Bridge System On Ramp.kicad_pcb, Bridge System On Ramp.kicad_sch]
2023-11-12 Added an audio module and a LCD module
    [Audio Module.kicad_pcb, Audio Module.kicad_sch, LCD Module.kicad_pcb, LCD Module.kicad_sch]
2023-11-13 Working on v2 of HW
    [Audio Module-B_Cu.gbr, Audio Module-B_Mask.gbr, Audio Module-B_Paste.gbr, Audio Module-B_Silkscreen.gbr, Audio Module-Edge_Cuts.gbr, Audio Module-F_Cu.gbr, Audio Module-F_Mask.gbr, Audio Module-F_Paste.gbr]
2023-11-28 mostly hardware updates - also MUX chip test code
    [Bridge System On Ramp-B_Cu.gbr, Bridge System On Ramp-B_Mask.gbr, Bridge System On Ramp-B_Paste.gbr, Bridge System On Ramp-B_Silkscreen.gbr, Bridge System On Ramp-Edge_Cuts.gbr, Bridge System On Ramp-F_Cu.gbr, Bridge System On Ramp-F_Mask.gbr, Bridge System On Ramp-F_Paste.gbr]
2023-12-06 updates to schematic
